ChronicMechatronic/Ramps-1.4.2-MultiVoltage/Ramps 1.4.2 MultiVoltage.kicad_pcb

## KiCad design Ramps 1.4.2 MultiVoltage.kicad_pcb (2023-09-25)

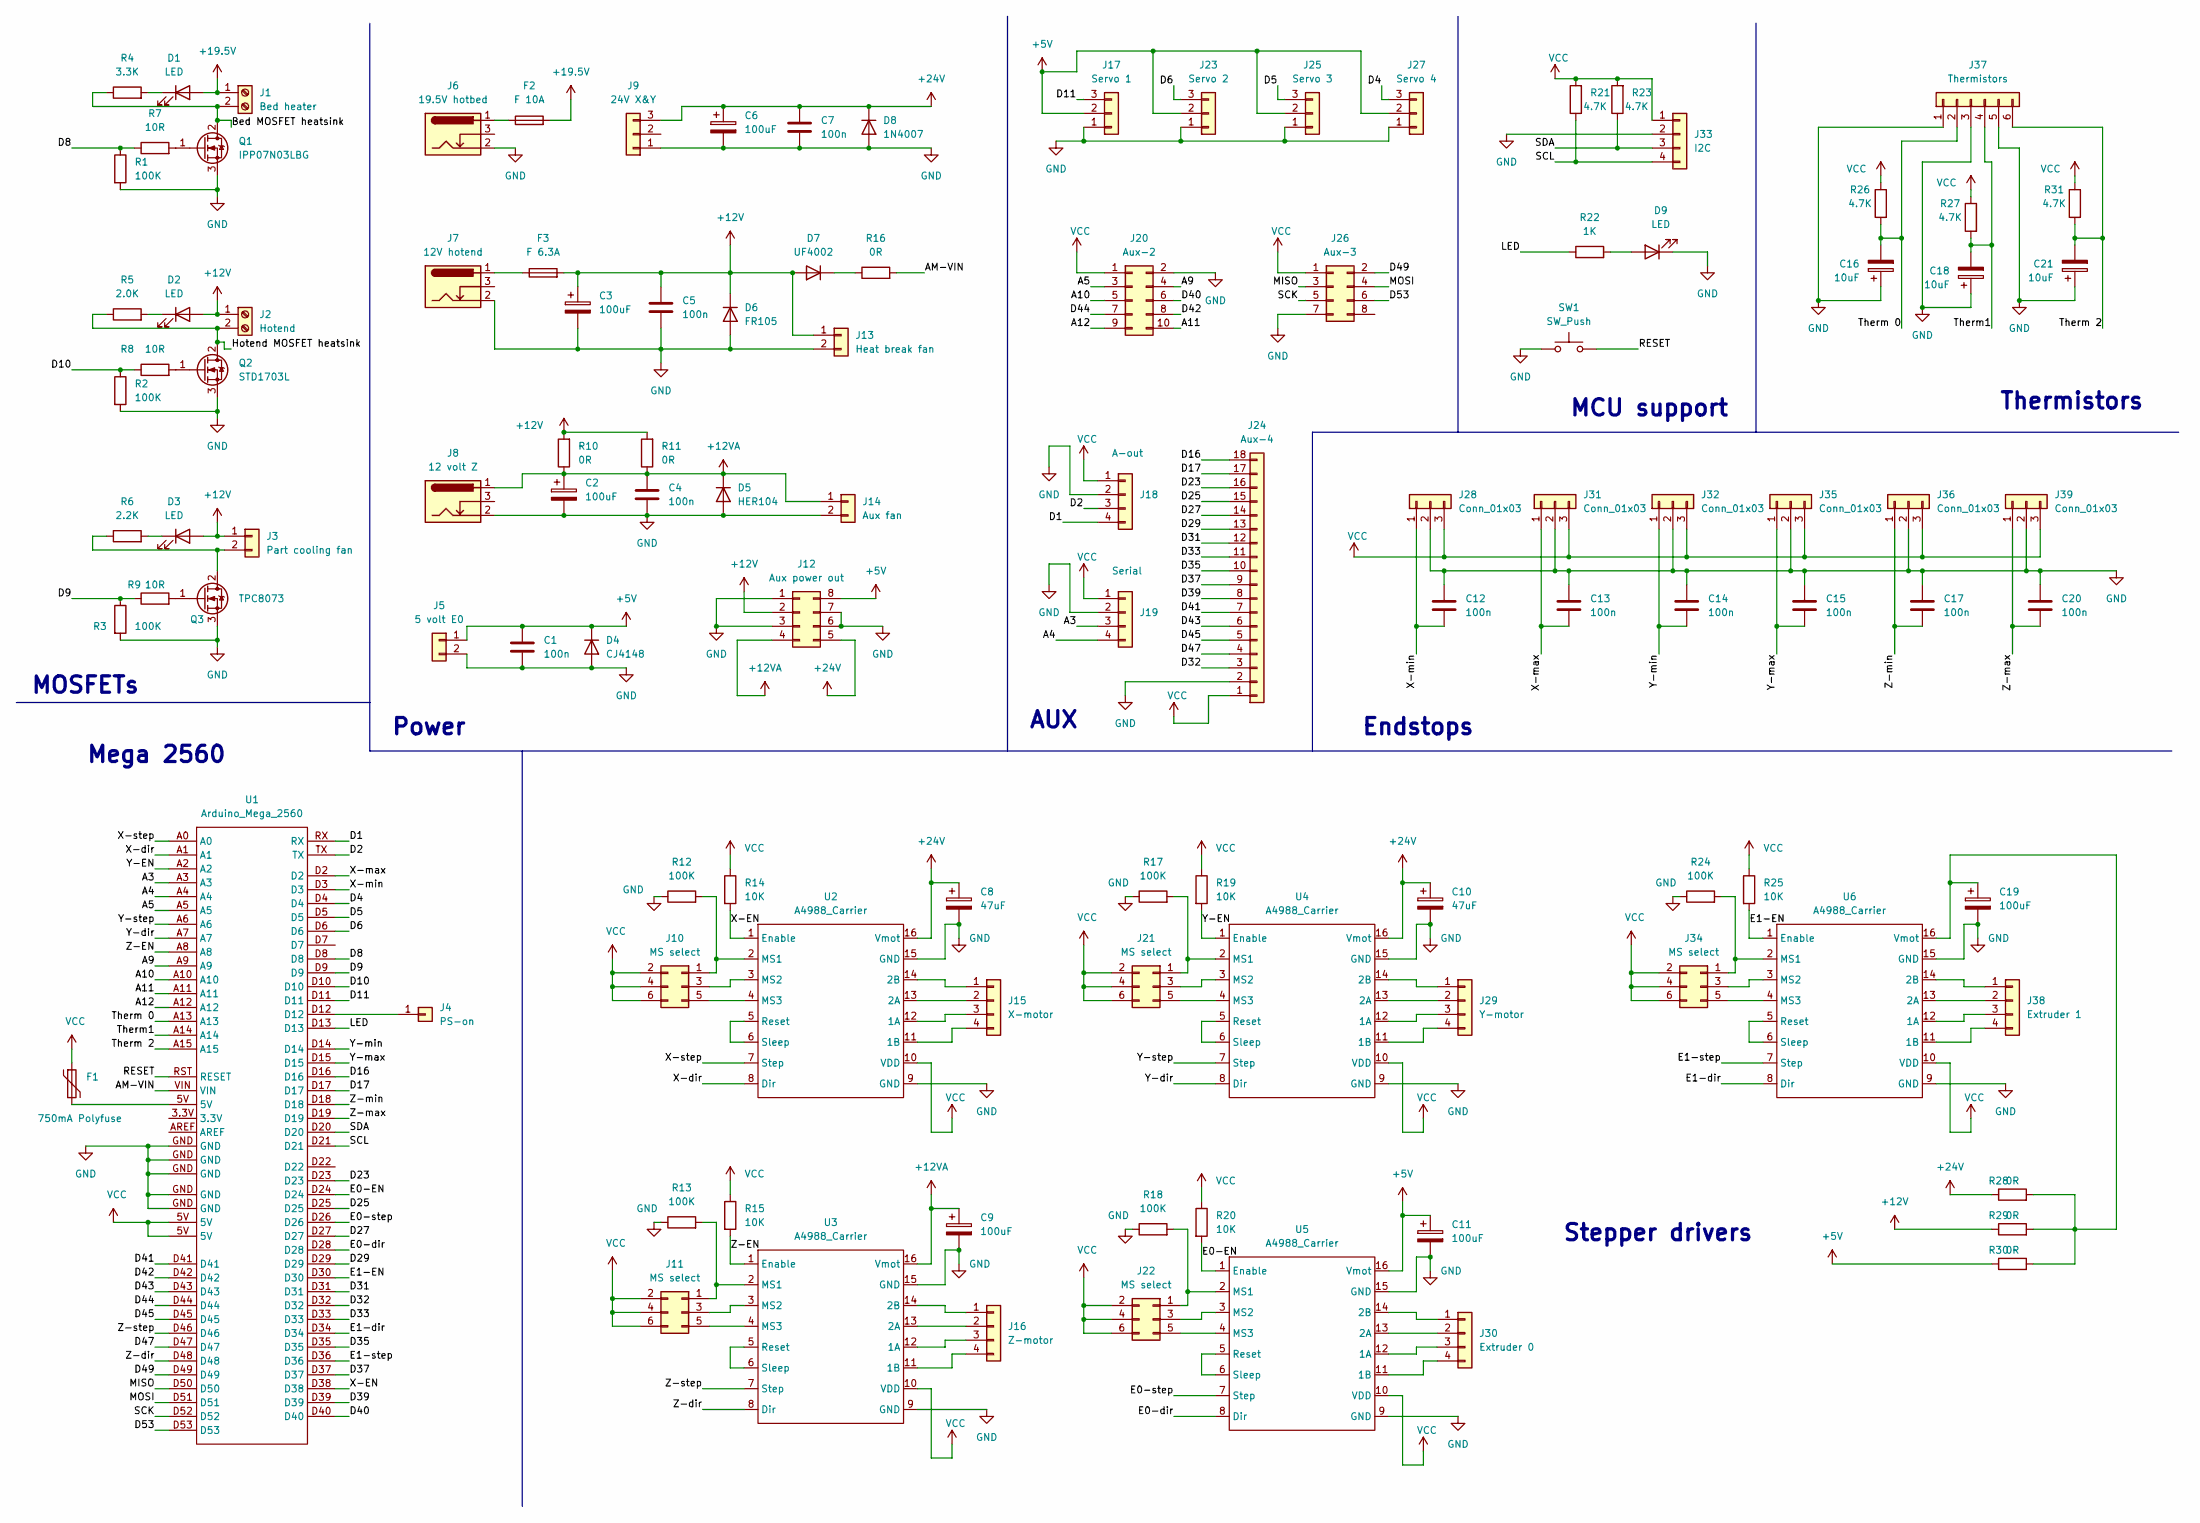
[picture p1: schematic Ramps 1.4.2 MultiVoltage.kicad_sch, Ramps 1.4.2 MultiVoltage]

Parts:
C1, C12, C13, C14, C15, C17, C20: 100n; C_0603_1608Metric
C2, C3, C9: 100uF; CP_Radial_D6.3mm_P2.50mm
C4, C5: 100n; C_0805_2012Metric
C6, C19: 100uF; CP_Radial_D8.0mm_P3.50mm
C7: 100n; C_1206_3216Metric
C8, C10: 47uF; CP_Radial_D8.0mm_P3.50mm
C11: 100uF; CP_Radial_D5.0mm_P2.50mm
C16, C18, C21: 10uF; CP_Radial_D4.0mm_P1.50mm
D1, D2, D3, D9: LED; LED_D5.0mm
D4: CJ4148; D_DO-35_SOD27_P7.62mm_Horizontal
D5: HER104; D_DO-41_SOD81_P2.54mm_Vertical_KathodeUp
D6: FR105; D_DO-41_SOD81_P2.54mm_Vertical_KathodeUp
D7: UF4002; D_DO-41_SOD81_P7.62mm_Horizontal
D8: 1N4007; D_DO-41_SOD81_P2.54mm_Vertical_AnodeUp
F1: 750mA Polyfuse; Fuse_Bourns_MF-RG400
F2: F 10A; Fuseholder_Cylinder-5x20mm_Stelvio-Kontek_PTF78_Horizontal_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
F3: F 6.3A; Standard 2-piece fuseholder
J1: Bed heater; TerminalBlock_Phoenix_MKDS-1,5-2_1x02_P5.00mm_Horizontal
J2: Hotend; TerminalBlock_Phoenix_MKDS-1,5-2_1x02_P5.00mm_Horizontal
J3: Part cooling fan; JST_XA_B02B-XASK-1_1x02_P2.50mm_Vertical
J4: PS-on; PinHeader_1x01_P2.54mm_Vertical
J5: 5 volt E0; JST_XH_S2B-XH-A-1_1x02_P2.50mm_Horizontal
J6: 19.5V hotbed; 5.5x2.5mm barrel jack connector square
J7: 12V hotend; BarrelJack_Horizontal
J8: 12 volt Z; BarrelJack_Horizontal
J9: 24V X&Y; JST_EH_S3B-EH_1x03_P2.50mm_Horizontal
J10, J11, J21, J22, J34: MS select; PinHeader_2x03_P2.54mm_Vertical
J12: Aux power out; PinHeader_2x04_P2.54mm_Vertical
J13: Heat break fan; JST_XA_B02B-XASK-1-A_1x02_P2.50mm_Vertical
J14: Aux fan; JST_XA_B02B-XASK-1-A_1x02_P2.50mm_Vertical
J15: X-motor; PinHeader_1x04_P2.54mm_Vertical
J16: Z-motor; PinHeader_1x04_P2.54mm_Vertical
J17: Servo 1; PinHeader_1x03_P2.54mm_Vertical
J18: A-out; PinHeader_1x04_P2.54mm_Vertical
J19: Serial; PinHeader_1x04_P2.54mm_Vertical
J20: Aux-2; PinHeader_2x05_P2.54mm_Vertical
J23: Servo 2; PinHeader_1x03_P2.54mm_Vertical
J24: Aux-4; PinHeader_1x18_P2.54mm_Vertical
J25: Servo 3; PinHeader_1x03_P2.54mm_Vertical
J26: Aux-3; PinHeader_2x04_P2.54mm_Vertical
J27: Servo 4; PinHeader_1x03_P2.54mm_Vertical
J28, J31, J32, J35, J36, J39: Conn_01x03; PinHeader_1x03_P2.54mm_Vertical
J29: Y-motor; PinHeader_1x04_P2.54mm_Vertical
J30: Extruder 0; PinHeader_1x04_P2.54mm_Vertical
J33: I2C; PinHeader_1x04_P2.54mm_Vertical
J37: Thermistors; PinHeader_1x06_P2.54mm_Vertical
J38: Extruder 1; PinHeader_1x04_P2.54mm_Vertical
Q1: IPP07N03LBG; TO-263-2
Q2: STD1703L; TO-252-2
Q3: TPC8073; TPC8073 MOSFET SOIC-8_4.5x5.08mm_P1.27mm
R1, R2, R3, R12, R13, R17, R18, R24: 100K; R_0603_1608Metric
R4: 3.3K; R_0805_2012Metric
R5: 2.0K; R_0805_2012Metric
R6: 2.2K; R_0805_2012Metric
R7, R8, R9: 10R; R_0603_1608Metric
R10, R11, R16, R28, R29, R30: 0R; R_1206_3216Metric
R14, R15, R19, R20, R25: 10K; R_0603_1608Metric
R21, R23, R26, R27, R31: 4.7K; R_0603_1608Metric
R22: 1K; R_0603_1608Metric
SW1: SW_Push; SW_Tactile_SPST_Angled_PTS645Vx39-2LFS
U1: Arduino_Mega_2560; Arduino Mega 252560 shield
U2, U3, U4, U5, U6: A4988_Carrier; A4988 carrier

Connections:
+5V: C1.1, C11.1, D4.1 (K), J5.1, J12.8, J17.2, J23.2, J25.2, J27.2, R30.1, U5.16 (Vmot)
+12V: C3.1, C5.1, D2.2 (A), D3.2 (A), D6.1 (K), D7.2 (A), F3.2, J2.1, J3.1, J12.2, J13.1, R10.2, R11.2, R29.1; also elsewhere on the board
+12VA: C2.1, C4.1, C9.1, D5.1 (K), J8.1, J12.4, J14.1, R10.1, R11.1, U3.16 (Vmot)
+19.5V: D1.2 (A), F2.2, J1.1
+24V: C6.1, C7.1, C8.1, C10.1, D8.1 (K), J9.3, J12.5, R28.1, U2.16 (Vmot), U4.16 (Vmot)
/A3: J19.3, U1.A3; also elsewhere on the board
/A4: J19.4, U1.A4; also elsewhere on the board
/A5: J20.3, U1.A5
/A9: J20.4, U1.A9
/A10: J20.5, U1.A10
/A11: J20.10, U1.A11
/A12: J20.9, U1.A12
/AM-VIN: R16.2, U1.VIN
/Bed MOSFET heatsink: J1.2, Q1.2 (D), R4.1
/D1: J18.4, U1.RX; also elsewhere on the board
/D2: J18.3, U1.TX; also elsewhere on the board
/D4: J27.3, U1.D4
/D5: J25.3, U1.D5
/D6: J23.3, U1.D6
/D8: R1.1, R7.1, U1.D8
/D9: R3.1, R9.1, U1.D9
/D10: R2.1, R8.1, U1.D10
/D11: J17.3, U1.D11
/D16: J24.18, U1.D16; also elsewhere on the board
/D17: J24.17, U1.D17; also elsewhere on the board
/D23: J24.16, U1.D23; also elsewhere on the board
/D25: J24.15, U1.D25; also elsewhere on the board
/D27: J24.14, U1.D27; also elsewhere on the board
/D29: J24.13, U1.D29; also elsewhere on the board
/D31: J24.12, U1.D31; also elsewhere on the board
/D32: J24.3, U1.D32; also elsewhere on the board
/D33: J24.11, U1.D33; also elsewhere on the board
/D35: J24.10, U1.D35; also elsewhere on the board
/D37: J24.9, U1.D37; also elsewhere on the board
/D39: J24.8, U1.D39; also elsewhere on the board
/D40: J20.6, U1.D40
/D41: J24.7, U1.D41; also elsewhere on the board
/D42: J20.8, U1.D42
/D43: J24.6, U1.D43; also elsewhere on the board
/D44: J20.7, U1.D44
/D45: J24.5, U1.D45; also elsewhere on the board
/D47: J24.4, U1.D47; also elsewhere on the board
/D49: J26.2, U1.D49
/D53: J26.6, U1.D53
/E0-EN: R20.2, U1.D24, U5.1 (Enable)
/E0-dir: U1.D28, U5.8 (Dir)
/E0-step: U1.D26, U5.7 (Step)
/E1-EN: R25.2, U1.D30, U6.1 (Enable)
/E1-dir: U1.D34, U6.8 (Dir)
/E1-step: U1.D36, U6.7 (Step)
/Hotend MOSFET heatsink: J2.2, Q2.2 (D), R5.1
/LED: R22.1, U1.D13
/MISO: J26.3, U1.D50
/MOSI: J26.4, U1.D51
/RESET: SW1.2, U1.RST (RESET)
/SCK: J26.5, U1.D52
/SCL: J33.4, R21.1, U1.D21
/SDA: J33.3, R23.1, U1.D20
/Therm1: C18.2, J37.4, R27.2, U1.A14
/Therm 0: C16.2, J37.2, R26.2, U1.A13
/Therm 2: C21.2, J37.6, R31.2, U1.A15
/X-EN: R14.2, U1.D38, U2.1 (Enable)
/X-dir: U1.A1, U2.8 (Dir)
/X-max: C13.2, J31.1, U1.D2
/X-min: C12.2, J28.1, U1.D3
/X-step: U1.A0, U2.7 (Step)
/Y-EN: R19.2, U1.A2, U4.1 (Enable)
/Y-dir: U1.A7, U4.8 (Dir)
/Y-max: C15.2, J35.1, U1.D15
/Y-min: C14.2, J32.1, U1.D14
/Y-step: U1.A6, U4.7 (Step)
/Z-EN: R15.2, U1.A8, U3.1 (Enable)
/Z-dir: U1.D48, U3.8 (Dir)
/Z-max: C20.2, J39.1, U1.D19
/Z-min: C17.2, J36.1, U1.D18
/Z-step: U1.D46, U3.7 (Step)
GND: C1.2, C2.2, C3.2, C4.2, C5.2, C6.2, C7.2, C8.2, C9.2, C10.2, C11.2, C12.1, C13.1, C14.1, C15.1, C16.1, C17.1, C18.1, C19.2, C20.1, C21.1, D4.2 (A), D5.2 (A), D6.2 (A), D8.2 (A), D9.1 (K), J5.2, J6.2, J7.2, J8.2, J9.1, J12.1, J12.3, J12.6, J12.7, J13.2, J14.2, J17.1, J18.2, J19.2, J20.2, J23.1, J24.2, J25.1, J26.7, J27.1, J28.2, J31.2, J32.2, J33.2, J35.2, J36.2, J37.1, J37.3, J37.5, J39.2, Q1.3 (S), Q2.3 (S), Q3.3 (S), R1.2, R2.2, R3.2, R12.1, R13.1, R17.1, R18.1, R24.1, SW1.1, U1.GND, U2.9 (GND), U2.15 (GND), U3.9 (GND), U3.15 (GND), U4.9 (GND), U4.15 (GND), U5.9 (GND), U5.15 (GND), U6.9 (GND), U6.15 (GND); also elsewhere on the board
unnamed: C19.1, R28.2, R29.2, R30.2, U6.16 (Vmot)
unnamed: D1.1 (K), R4.2
unnamed: D2.1 (K), R5.2
unnamed: D3.1 (K), R6.2
unnamed: D7.1 (K), R16.1
unnamed: D9.2 (A), R22.2
unnamed: F2.1, J6.1
unnamed: F3.1, J7.1
unnamed 85: J3.2, Q3.2 (D), R6.1; also elsewhere on the board
unnamed: J4.1, U1.D12
unnamed: J10.1, R12.2, U2.2 (MS1)
unnamed: J10.3, U2.3 (MS2)
unnamed: J10.5, U2.4 (MS3)
unnamed: J11.1, R13.2, U3.2 (MS1)
unnamed: J11.3, U3.3 (MS2)
unnamed: J11.5, U3.4 (MS3)
unnamed: J15.1, U2.14 (2B)
unnamed: J15.2, U2.13 (2A)
unnamed: J15.3, U2.12 (1A)
unnamed: J15.4, U2.11 (1B)
unnamed: J16.1, U3.14 (2B)
unnamed: J16.2, U3.13 (2A)
unnamed: J16.3, U3.12 (1A)
unnamed: J16.4, U3.11 (1B)
unnamed: J21.1, R17.2, U4.2 (MS1)
unnamed: J21.3, U4.3 (MS2)
unnamed: J21.5, U4.4 (MS3)
unnamed: J22.1, R18.2, U5.2 (MS1)
unnamed: J22.3, U5.3 (MS2)
unnamed: J22.5, U5.4 (MS3)
unnamed: J29.1, U4.14 (2B)
unnamed: J29.2, U4.13 (2A)
unnamed: J29.3, U4.12 (1A)
unnamed: J29.4, U4.11 (1B)
unnamed: J30.1, U5.14 (2B)
unnamed: J30.2, U5.13 (2A)
unnamed: J30.3, U5.12 (1A)
unnamed: J30.4, U5.11 (1B)
unnamed: J34.1, R24.2, U6.2 (MS1)
unnamed: J34.3, U6.3 (MS2)
unnamed: J34.5, U6.4 (MS3)
unnamed: J38.1, U6.14 (2B)
unnamed: J38.2, U6.13 (2A)
unnamed: J38.3, U6.12 (1A)
unnamed: J38.4, U6.11 (1B)
unnamed: Q1.1 (G), R7.2
unnamed: Q2.1 (G), R8.2
unnamed: Q3.1 (G), R9.2
unnamed: U2.5 (Reset), U2.6 (Sleep)
unnamed: U3.5 (Reset), U3.6 (Sleep)
unnamed: U4.5 (Reset), U4.6 (Sleep)
unnamed: U5.5 (Reset), U5.6 (Sleep)
unnamed: U6.5 (Reset), U6.6 (Sleep)

Notes on the sheet:
AUX
MOSFETs
Mega 2560
Power
Endstops
MCU support
Thermistors
Stepper drivers

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
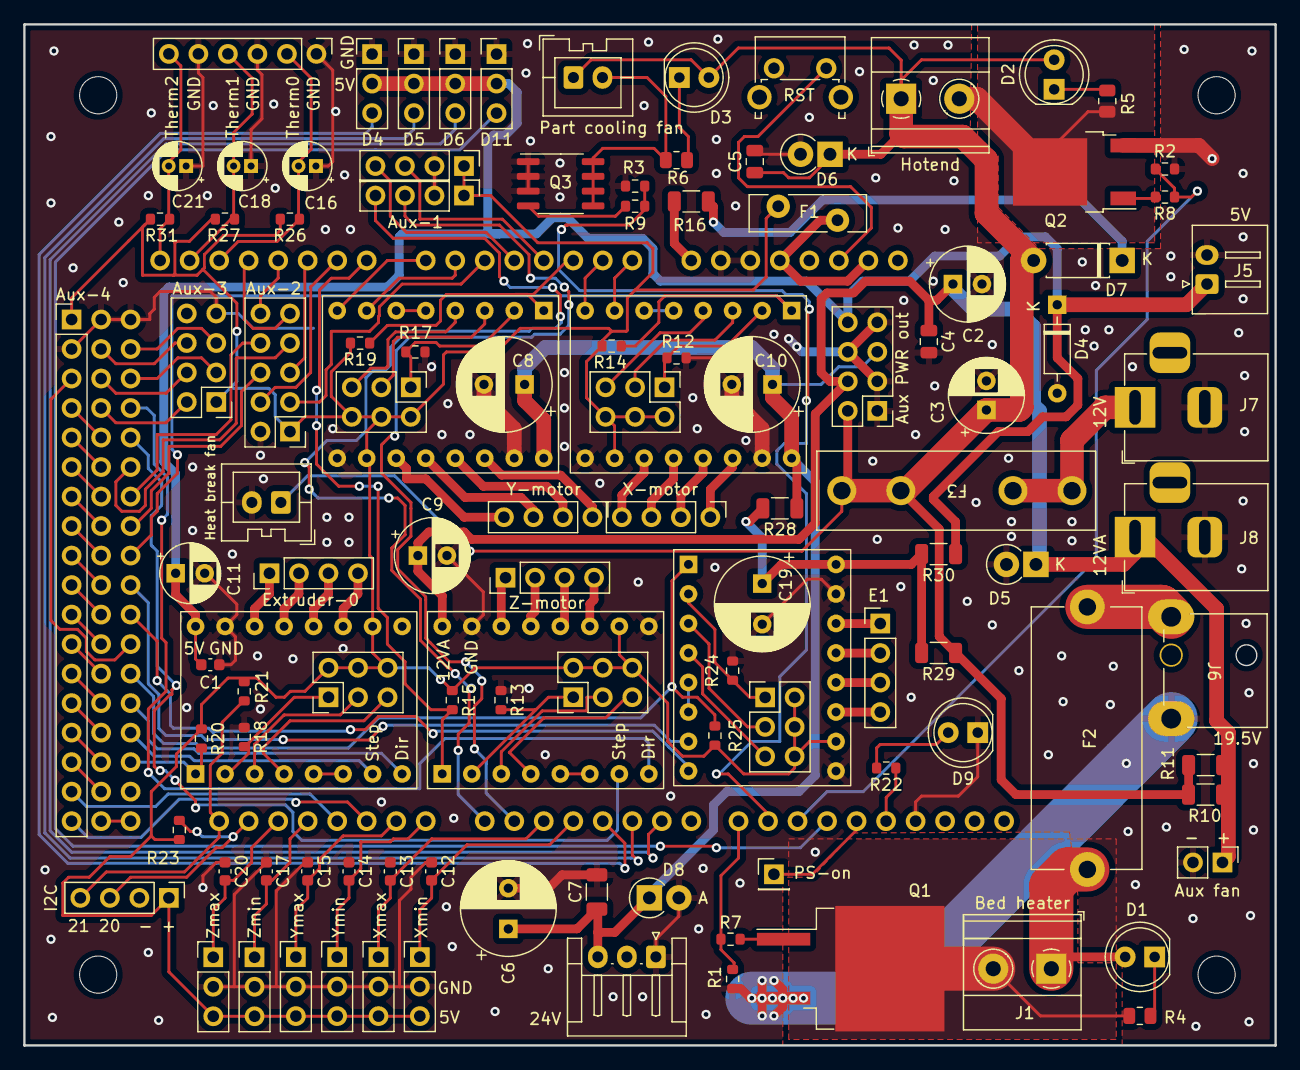
[picture p2: board Ramps 1.4.2 MultiVoltage.kicad_pcb from above]

Board: 2 copper layers, 107.7 x 87.9 mm, 117 parts (0 on the bottom side), 132 nets.

Other parts of the board:
Aux-1: A-out; PinHeader_1x04_P2.54mm_Vertical
Aux-4: Aux-4; PinHeader_1x18_P2.54mm_Vertical
Part cooling fan: Part cooling fan; JST_XA_B02B-XASK-1_1x02_P2.50mm_Vertical
REF1, REF2, REF3, REF4: MountingHole_3.2mm_M3
SRL: Serial; PinHeader_1x04_P2.54mm_Vertical

Their connections:
+12V: Part cooling fan.1; also elsewhere on the board
/A3: SRL.3; also elsewhere on the board
/A4: SRL.4; also elsewhere on the board
/D1: Aux-1.4; also elsewhere on the board
/D2: Aux-1.3; also elsewhere on the board
/D16: Aux-4.18; also elsewhere on the board
/D17: Aux-4.17; also elsewhere on the board
/D23: Aux-4.16; also elsewhere on the board
/D25: Aux-4.15; also elsewhere on the board
/D27: Aux-4.14; also elsewhere on the board
/D29: Aux-4.13; also elsewhere on the board
/D31: Aux-4.12; also elsewhere on the board
/D32: Aux-4.3; also elsewhere on the board
/D33: Aux-4.11; also elsewhere on the board
/D35: Aux-4.10; also elsewhere on the board
/D37: Aux-4.9; also elsewhere on the board
/D39: Aux-4.8; also elsewhere on the board
/D41: Aux-4.7; also elsewhere on the board
/D43: Aux-4.6; also elsewhere on the board
/D45: Aux-4.5; also elsewhere on the board
/D47: Aux-4.4; also elsewhere on the board
GND: Aux-1.2, Aux-4.2, SRL.2; also elsewhere on the board
unnamed 85: Part cooling fan.2; also elsewhere on the board
